reco-project/kit/hardware/case/reco-kit-case-main.stl

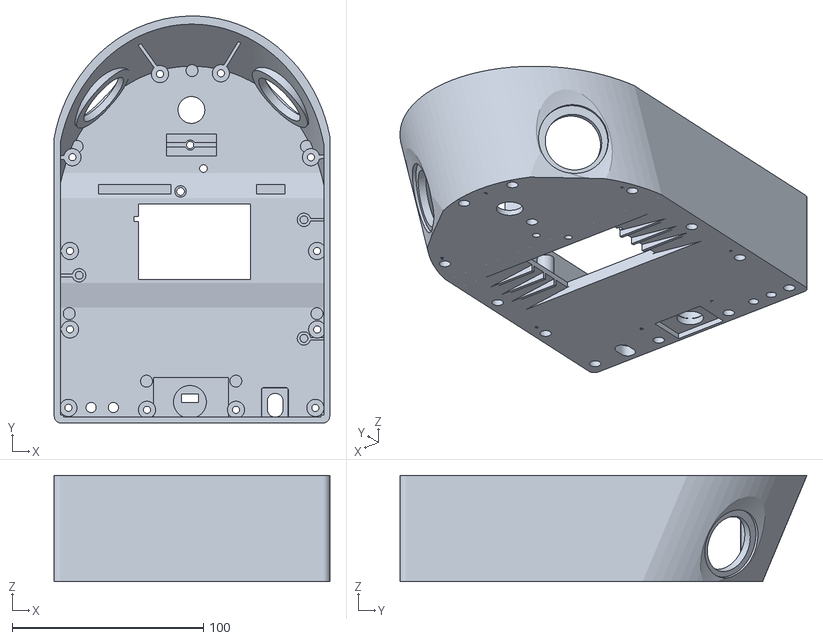
[picture p2: CAD file, 2026-07-26]
hardware/case/reco-kit-case-main.stl
144.0 x 212.7 x 55.5
