reco-project/kit/hardware/case/reco-kit-case-bottom.stl

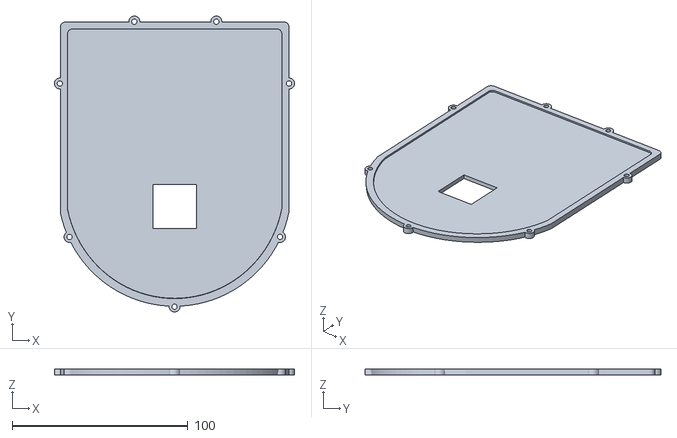
[picture p3: CAD file, 2026-07-26]
hardware/case/reco-kit-case-bottom.stl
136.8 x 168.6 x 3.50
