reco-project/kit/hardware/case/reco-kit-case-parts.stl

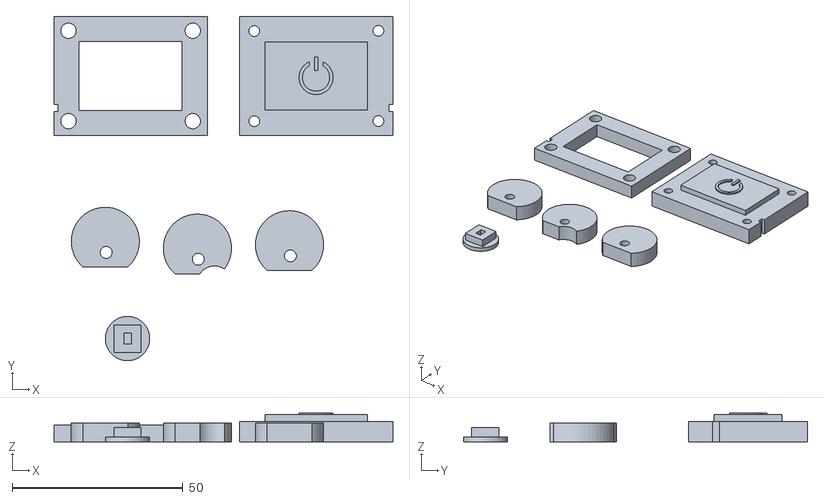
[picture p4: CAD file, 2026-07-26]
hardware/case/reco-kit-case-parts.stl
99.4 x 101.0 x 8.50
