reco-project/kit/hardware/case/reco-kit-case-insulation.stl

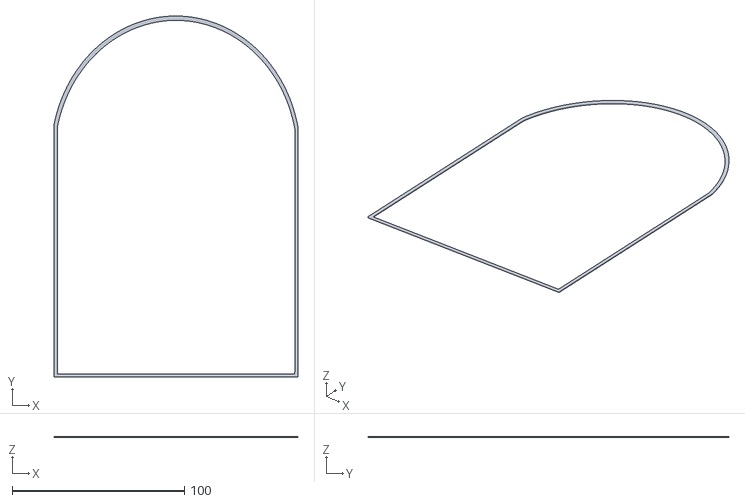
[picture p5: CAD file, 2026-07-26]
hardware/case/reco-kit-case-insulation.stl
141.6 x 209.5 x 0.803
