reco-project/kit/hardware/case/reco-kit-case-bracket.stl

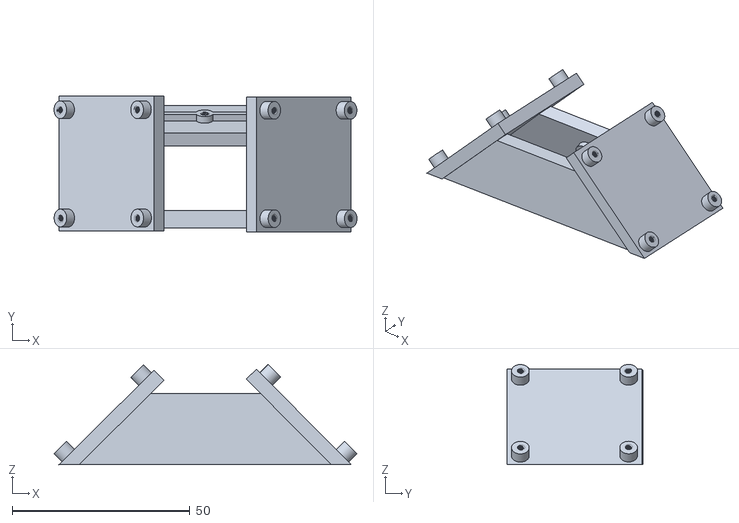
[picture p6: CAD file, 2026-07-26]
hardware/case/reco-kit-case-bracket.stl
85.3 x 38.2 x 28.2
