reco-project/kit/hardware/case/reco-kit-case-thermoform.stl

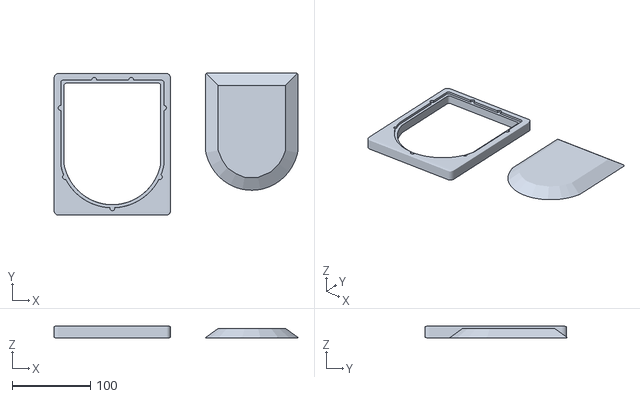
[picture p7: CAD file, 2026-07-26]
hardware/case/reco-kit-case-thermoform.stl
311.6 x 181.8 x 15.0
