reco-project/kit/hardware/case/reco-kit-case-top.stl

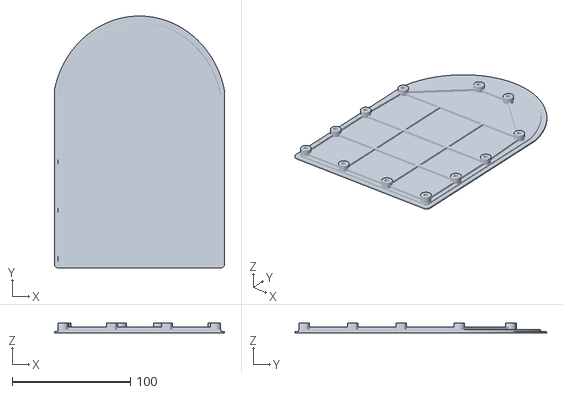
[picture p8: CAD file, 2026-07-26]
hardware/case/reco-kit-case-top.stl
144.0 x 212.9 x 8.50
