reco-project/kit/hardware/case/reco-kit-case-battery.stl

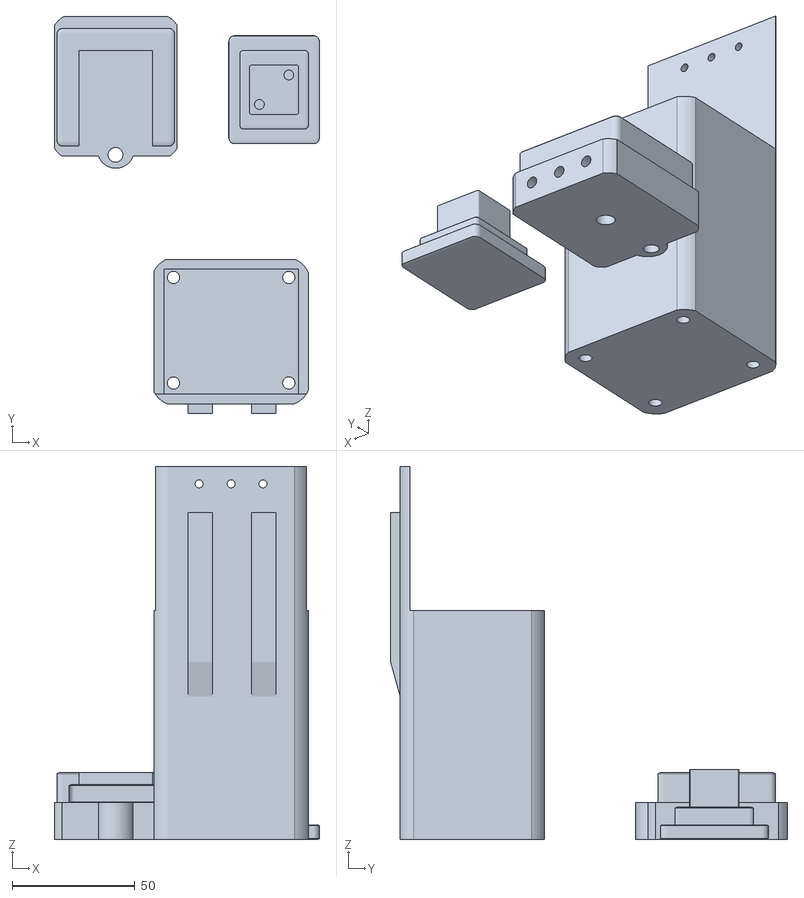
[picture p9: CAD file, 2026-07-26]
hardware/case/reco-kit-case-battery.stl
108.0 x 161.9 x 152.0
