reco-project/kit/driver/imx477_mode_tbls.h

/* SPDX-License-Identifier: GPL-2.0-only */
/*
 * Copyright (c) 2020-2023, NVIDIA CORPORATION & AFFILIATES. All rights reserved.
 *
 */

#ifndef __IMX477_I2C_TABLES__
#define __IMX477_I2C_TABLES__

#include <media/camera_common.h>

#define IMX477_TABLE_WAIT_MS 0
#define IMX477_TABLE_END 1
#define IMX477_WAIT_MS 1
#define IMX477_STANDBY_REG 0x0100

#define imx477_reg struct reg_8

static const imx477_reg imx477_start[] = {
	{IMX477_STANDBY_REG, 0x1},
	{IMX477_TABLE_WAIT_MS, IMX477_WAIT_MS*3},
	{IMX477_TABLE_END, 0x00}
};

static const imx477_reg imx477_stop[] = {
	{IMX477_STANDBY_REG, 0x0},
	{IMX477_TABLE_END, 0x00}
};

static const imx477_reg imx477_mode_common[] = {
	/* software reset */
	{0x0103, 0x01},
	{IMX477_TABLE_WAIT_MS, IMX477_WAIT_MS*10},
	{0x0136, 0x18},
	{0x0137, 0x00},
	{0x0808, 0x02},
	{0xE07A, 0x01},
	{0xE000, 0x00},
	{0x4AE9, 0x18},
	{0x4AEA, 0x08},
	{0xF61C, 0x04},
	{0xF61E, 0x04},
	{0x4AE9, 0x21},
	{0x4AEA, 0x80},
	{0x38A8, 0x1F},
	{0x38A9, 0xFF},
	{0x38AA, 0x1F},
	{0x38AB, 0xFF},
	{0x420B, 0x01},
	{0x55D4, 0x00},
	{0x55D5, 0x00},
	{0x55D6, 0x07},
	{0x55D7, 0xFF},
	{0x55E8, 0x07},
	{0x55E9, 0xFF},
	{0x55EA, 0x00},
	{0x55EB, 0x00},
	{0x574C, 0x07},
	{0x574D, 0xFF},
	{0x574E, 0x00},
	{0x574F, 0x00},
	{0x5754, 0x00},
	{0x5755, 0x00},
	{0x5756, 0x07},
	{0x5757, 0xFF},
	{0x5973, 0x04},
	{0x5974, 0x01},
	{0x5D13, 0xC3},
	{0x5D14, 0x58},
	{0x5D15, 0xA3},
	{0x5D16, 0x1D},
	{0x5D17, 0x65},
	{0x5D18, 0x8C},
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
	{IMX477_TABLE_END, 0x0000}

};

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
	IMX477_MODE_3840x2160_30FPS,
	IMX477_MODE_4032x3040_30FPS,
	IMX477_MODE_4032x3040_30FPS_4LANE,
	IMX477_MODE_1920x1080_60FPS,
	IMX477_MODE_2028x1520_60FPS,
	IMX477_MODE_3840x2160_30FPS_4LANE,
	IMX477_MODE_1920x1080_60FPS_4LANE,
	IMX477_MODE_COMMON,
	IMX477_START_STREAM,
	IMX477_STOP_STREAM,
};

static const imx477_reg *mode_table[] = {
	[IMX477_MODE_3840x2160_30FPS] = imx477_mode_3840x2160_30fps,
	[IMX477_MODE_4032x3040_30FPS] = imx477_mode_4032x3040_30fps,
	[IMX477_MODE_4032x3040_30FPS_4LANE] = imx477_mode_4032x3040_30fps_4lane,
	[IMX477_MODE_1920x1080_60FPS] = imx477_mode_1920x1080_60fps,
	[IMX477_MODE_2028x1520_60FPS] = imx477_mode_2028x1520_60fps,
	[IMX477_MODE_3840x2160_30FPS_4LANE] = imx477_mode_3840x2160_30fps_4lane,
	[IMX477_MODE_1920x1080_60FPS_4LANE] = imx477_mode_1920x1080_60fps_4lane,
	[IMX477_MODE_COMMON] = imx477_mode_common,
	[IMX477_START_STREAM] = imx477_start,
	[IMX477_STOP_STREAM] = imx477_stop,
};

static const int imx477_30_fr[] = {
	30,
};

static const int imx477_60_fr[] = {
	60,
};

static const struct camera_common_frmfmt imx477_frmfmt[] = {
	{{4032, 3040}, imx477_30_fr, 1, 0, IMX477_MODE_4032x3040_30FPS},
	{{3840, 2160}, imx477_30_fr, 1, 0, IMX477_MODE_3840x2160_30FPS},
	{{1920, 1080}, imx477_60_fr, 1, 0, IMX477_MODE_1920x1080_60FPS},
	{{2028, 1520}, imx477_60_fr, 1, 0, IMX477_MODE_2028x1520_60FPS},
};
#endif /* __IMX477_I2C_TABLES__ */
